cesareyeserrano/esp32-desk-controller/docs/historia/README.md

# Historia

Documentos de origen, **congelados**. No se editan ni se corrigen, ni siquiera
cuando contienen errores.

Están aquí para poder reconstruir qué se creía en cada momento. Un documento
histórico corregido a posteriori pierde exactamente lo que lo hace útil.

## Contenido

### `HANDOVER-2026-07-27.md`

Handover consolidado de las sesiones previas a la existencia de esta política.
Fuente de casi todo lo que hoy está repartido por los documentos temáticos.

**Contiene un error conocido:** el circuito de divisores que propone
(800 Ω / 1.72 kΩ) rompería el bus. Corregido en
[ADR-005](../DECISIONS.md). **No montar el cableado que describe.**
