cesareyeserrano/esp32-desk-controller/docs/SEGURIDAD.md

# Safety

> Reviewed before opening every new phase.
>
> *Documento en inglés desde el 2026-09-02. La bitácora y los ADR siguen en
> español; ver [POLITICA_DOCUMENTACION.md](POLITICA_DOCUMENTACION.md).*

---

## Electrical risk (phases 2 and 3)

**Unplug the desk from mains for any resistance or continuity measurement.**
Measuring resistance on a powered circuit gives false readings and can damage
the multimeter.

**Never force SDA high with a push-pull output.** While the AiP650 is pulling
that line down, doing so is a short circuit against the chip's own output. The
chip cannot be replaced, and the whole handset goes with it. See
[ADR-011](DECISIONS.md).

**The 6-wire cable between the two columns is never touched.** It carries the
**29 V** from the adapter and the motor current. There is nothing in there that
this project needs.

**The ESP32 is never powered from the desk, not even from its 5 V.** Those 5 V
are generated by the control box for a chip that draws 0.3 mA, while an ESP32
with WiFi spikes into the hundreds of milliamps, and nobody knows what that
regulator tolerates. USB from the Mac, always. See [ADR-007](DECISIONS.md).

**The yellow wire (5 V) never connects to the ESP32.** Not in any phase. The
ESP32 is USB powered ([ADR-007](DECISIONS.md)).

**No 5 V line ever touches a GPIO directly.** ESP32 GPIOs tolerate 3.6 V as an
absolute maximum. This covers the data lines ([ADR-005](DECISIONS.md)) and the
buttons ([ADR-004](DECISIONS.md)).

**Before connecting the ESP32, confirm the handset still works with the taps
soldered on.** Skip that order and any later fault becomes impossible to pin
down: was it the solder joint or the probe?

**Power the ESP32 over USB before connecting the wires to the divider, and
disconnect those wires before removing USB.** With the ESP32 unpowered and the
probe sitting on a live bus, the GPIO protection diode clamps the divider node
and drags the bus down to about 2.85 V, below the chip's threshold, so the
handset fails. There is no damage, since the current is around 210 µA limited by
the 9.1 kΩ, but the symptom would show up right after soldering and point at the
joints. See [ADR-019](DECISIONS.md).

**Check the bus level with the multimeter before accepting the assembly, and
judge by the ratio between two readings rather than an absolute threshold.** A
multimeter averages and the bus is switching, so both readings come out below
the calculated value by an unknown amount. Measure red to blue and green to blue
without the probe and then with it, desk still and the same number on screen:
the ratio should sit around **0.80**, and anything below **0.70** means
disconnect. Full procedure in [HARDWARE.md](HARDWARE.md), reasoning in
[ADR-018](DECISIONS.md).

---

## Mechanical risk (phase 3 onward)

A desk that moves on its own can trap hands, cables or pets. The surface lifts
with enough force to raise a monitor, which is enough force to hurt someone.

⚠️ **A real failure, twice: the desk ran into its bottom stop** (2026-09-25
11:41 and 2026-09-29 15:41, both descending from 115 to 73 cm). The give-way to
the handset drops the trip **without braking**, because it assumes the person's
own press already stopped the desk. But the press was the firmware's own: it
attributes only the FIRST reading of its own key, and it often misses that
reading, because it decodes just the last 2-3 ms burst of the pulse against a
~40 ms keyboard scan. When the give-way lands right as the long pulse starts
continuous travel, **nothing brakes it**: only the physical stop.

**Fixed the same day, [ADR-035](DECISIONS.md)**: a press is claimed by key code
for the whole window, and giving way during a trip now brakes, which `stopTravel`
verifies and retries. **Verified in the field on 2026-09-30**: a reminder descent
braked at the target by itself, 81 then 80. The cost is deliberate: a person
HOLDING a key has their travel braked once. Detail in
[BITACORA.md](BITACORA.md).

Rules for whenever actuation exists:

- **Software height limits**, minimum and maximum, checked against the height
  read from the bus. A command outside that range does not run.
- **No automatic movement without presence.** Automations that move the desk
  require confirmation that somebody is in front of it.
- **A stop is always available.** The physical handset stays connected and
  working through every phase. It is the panic button.
- **M1 and M2 pulses are bounded in hardware** ([ADR-010](DECISIONS.md)). A long
  close writes the preset instead of recalling it, and it fails silently.
- **A hung ESP32 is not hypothetical: it hung twice on 2026-08-03.** Not from a
  logic bug but from an electrical condition on a pin. A 175 kHz signal left it
  unresponsive, and it did not degrade gracefully.

  **Corrected on 2026-08-06, because this evidence was being cited with more
  force than it carries:** those hangs came from **interrupt saturation**, with
  `attachInterrupt` hooked to both pins. **That capture design no longer
  exists.** The sniffer moved to burst sampling and hooks no interrupts to those
  lines. The specific mechanism that was demonstrated is gone.

  What still stands is the generic part. Any firmware can hang some other way,
  and the current one disables interrupts for 2 ms per burst. But **this is a
  reasonable precaution, not a requirement backed by direct evidence.** The
  difference matters when the decision involves buying components.

  What does not change: **the only thing that can open a closed channel with
  dead firmware is hardware that does not depend on the CPU.**
- ⚠️ **Button wires go to pins 3 and 4 of the PC817, never to 1 and 2.** Pins 1
  and 2 are the LED and already carry the ESP32; pins 3 and 4 are the isolated
  switch. Soldering the button to pins 1 and 2 would tie the handset's 5 V to the
  ESP32 GPIO and destroy the isolation entirely.

- **All four channels carry the same 300 ms pulse limiter**
  ([ADR-023](DECISIONS.md)). Decided on 2026-08-06, closing what was blocking
  phase 3. **The firmware only emits taps; the hardware guarantees none lasts
  longer.**

  **Corrected on 2026-08-23, and it is an uncomfortable correction:** from the
  day this was written until then, **that watchdog did not exist**.
  [ADR-024](DECISIONS.md) decided it and nobody implemented it. The firmware
  configured no watchdog at all, and the pulse width was bounded by the very
  software that might hang. This document's promise was paper. The adversarial
  review of 2026-08-23 found it
  ([REVISION_FIRMWARE_2026-08-23.md](REVISION_FIRMWARE_2026-08-23.md), finding
  B1).

  **Since 2026-08-23 it does exist:** every pulse arms the ESP32 task watchdog
  with a budget of `width + 1 s` and panics on expiry. A hang with the pin high
  ends in a chip reset, the reset leaves the GPIOs as inputs, and the channel
  opens. It disarms when the pin is released. Verified in normal operation: it
  does not fire on legitimate pulses.

  **And the pulse now measures itself:** on release it compares the width
  achieved against the width requested, and any overrun beyond 100 ms is
  reported with `[!!]`. Bus decoding used to happen **inside** the contact and
  could stretch it without anyone knowing (finding B2). Now the capture happens
  during the pulse and the decoding after release.

  ⚠️ **Before wiring anything, measure the level of the control GPIOs during
  boot and reset.** All of this protection rests on a reset leaving the pins non
  conducting. **If any of them goes high at boot, the watchdog would activate
  the channel instead of opening it.**

  The measured thresholds behind this: a tap becomes **continuous travel**
  between **2.2 and 2.6 s**, and M1 or M2 **overwrite the preset** at **3.0 s**.
  At 300 ms there is seven times the margin below, and almost double the 160 ms
  minimum the chip needs to see a press at all.

  So **a stuck contact cannot start continuous travel or overwrite a preset**.
  At worst it moves a centimetre or recalls a memory.

- ⚠️ **Continuous travel cannot be stopped by opening a contact.** Measured:
  after release the desk kept going **5 cm in 5 s** upward and **6 cm in 6.6 s**
  downward. Stopping it requires **closing** a contact, not opening one, which
  is why no circuit acting on absence of signal is any use here.

  **Changed on 2026-08-21 ([ADR-028](DECISIONS.md)).** The design used to be
  *prevent continuous travel from ever starting*. It is now **admitted**, because
  the missing measurement was taken: **a short tap on the SAME channel brakes its
  own continuous travel**. With a single channel wired, there is a stop.

  ⚠️ **New risk, and of a different kind:** an ESP32 hang during travel leaves
  the desk moving with **nothing to stop it**. The watchdog from
  [ADR-024](DECISIONS.md) **does not help**, because it opens the channel, and
  opening does not brake. What remains is the physical stop and the handset.
  **That is a mitigation, not a guarantee.**

  **Hence: continuous travel only under supervision**, for as long as software
  limits based on the bus height do not exist. Taps
  ([ADR-027](DECISIONS.md), 800 ms) carry no such risk and remain the default
  mode.
- **A brake is always available.** Any button stops movement in progress, so any
  relay works as an emergency stop. Faced with an incoherent height reading,
  braking is the default action, not carrying on.
- **No movement starts on a stale height** ([ADR-012](DECISIONS.md)). If the
  display refresh stops or jumps incoherently during a movement, it brakes.
- **No retry loops.** If a movement does not reach the expected height, it stops
  and reports. It does not retry on its own: a misdecoded sensor retrying
  forever is a desk hammering against an end stop.
- **The reset button is never wired** ([ADR-008](DECISIONS.md)). It runs a
  recalibration that drives the surface down to the bottom stop, with no
  confirmation and no way to interrupt it. It stays physically out of the
  circuit, because that is stronger than a software check some bug can skip.

---

## The pulse cannot be aborted: a 2800 ms window

**Found on 2026-09-02**, from a question by the owner: *"my worry is when an HA
automation fires and I stop the desk by hand"*.

**Electrical risk: none, and this part is reasoned.** The optocoupler sits **in
parallel** with the handset button. Closing both at once is electrically
identical to pressing one key with two fingers: two switches in parallel, no
current conflict, and no way to damage anything.

**The risk is logical, and it is unevaluated.** During the pulse the channel
stays closed for **2800 ms with no way to abort**, because bus decoding happens
*after* the contact opens. That ordering comes from correction B2 of 2026-08-23,
which exists because decoding inside the pulse stretched it dangerously close to
the 3.0 s that overwrite a preset. While the pulse lasts, **the firmware is
blind to a person having pressed anything**.

If **the opposite key** is pressed inside that window, the control box sees
**UP and DOWN closed at the same time**.

⚠️ **What the box does with that combination IS NOT VERIFIED.** On desks of this
kind it is usually the way into calibration mode, which would lose the height
reference. Recoverable, but not tested here. **Assumed, not measured.**

**And it is not theoretical.** On 2026-09-02, with the reminder moving the desk:

```
09:31:54.0  the ESP32 closes UP (until ~09:31:56.8)
09:31:55    the owner presses UP     <- inside the window, same key: harmless
09:31:57    presses DOWN             <- ~200 ms after the contact opened
```

**The opposite key, two tenths of a second outside the window.**

**Mitigations, none applied:**

1. **Decode inside the pulse without printing**, so the contact can open as soon
   as an unattributed key shows up. This collides head on with correction B2, so
   it would need careful bounding to stay away from 3.0 s.
2. **Use the M1 and M2 presets** for the posture targets. The pulse drops from
   2800 to 800 ms and the box handles the travel. Needs an ADR, since it
   contradicts the owner's decision not to couple the physical presets to the
   system.

**Pending and cheap check:** press UP and DOWN together on the handset **with
the ESP32 disconnected**, and see what happens. That is the only thing that
turns this assumption into a fact. Proposed on 2026-09-02; the owner closed the
session before deciding.

## Risk of losing the desk

The control box is proprietary and does not get opened. If its configuration is
corrupted or the handset is damaged, there is no immediate replacement and no
way to diagnose it.

That is the reason for the read-only phase ([ADR-002](DECISIONS.md)): as long as
nothing is written to the bus, no ESP32 bug can alter the desk's state.
