cesareyeserrano/esp32-desk-controller/docs/historia/README-2026-07-27.md

# Escritorio elevable automatizado — ESP32 + Home Assistant

Automatizar un escritorio elevable Jiecang leyendo el bus de datos entre su caja
de control y el mando físico, para conocer la altura real en todo momento y
mover el escritorio a posiciones definidas desde Home Assistant.

## Estado

**Fase 2 — Sniffing del bus. Montaje pendiente.**

El hardware está identificado y el **pinout del cable verificado** por
continuidad: **rojo = CLK, verde = DIO, azul = GND, amarillo = 5 V**. Esto
corrige el handover original, que daba el rojo como alimentación.

El circuito de sonda está **definido**: divisor de 9.1 kΩ / 27 kΩ en rojo y
verde ([ADR-016](../DECISIONS.md)). Las 9.1 kΩ ya están; faltan **dos
resistencias de 27 kΩ** y nada más.

El firmware del sniffer está escrito, en
[firmware/desk_sniffer/](firmware/desk_sniffer/), aunque **sin compilar ni
probar**.

## Estado: el protocolo está descifrado ✅

**El 2026-08-06 se leyó la altura del escritorio directamente del bus**, y se
verificó contra lo que muestra la pantalla del mando en cuatro casos, incluido
uno de tres dígitos:

| Acción | Pantalla | Bus |
|---|---|---|
| Subir manual | 86 | `086` |
| Bajar manual | 77 | `077` |
| Ir a memoria | 117 | `117` |
| Ir a memoria | 80 | `080` |

**Y la altura se refresca durante el movimiento**, cada centímetro. Ese era el
riesgo que podía tumbar el proyecto entero: si el escritorio solo publicara la
altura al terminar de moverse, el lazo cerrado no funcionaría. **Funciona.**

Los cuatro botones están mapeados —subir `0x47`, bajar `0x57`, memorias `0x6F` y
`0x67`— y el reset queda sin capturar a propósito
([ADR-008](../DECISIONS.md)). Todo en [PROTOCOLO.md](../PROTOCOLO.md), con
las capturas crudas en [docs/capturas/](docs/capturas/).

Para llegar aquí hubo que reescribir la captura del sniffer: el bus corre a
**~202 kHz** y la captura por interrupción perdía flancos en silencio. Ahora
graba a ráfagas de 4 MHz y decodifica después.

**La fase 3 se cerró el 2026-08-22: el ESP32 controla el escritorio entero.**
Los cuatro canales verificados contra el bus, y los cuatro códigos coinciden con
los que se habían decodificado en julio leyendo el tráfico:

| Canal | Pin | Botón | Código |
|---|---|---|---|
| 1 | GPIO 27 | Subir | `0x47` |
| 2 | GPIO 26 | Bajar | `0x57` |
| 3 | GPIO 25 | Memoria 80 cm | `0x67` |
| 4 | GPIO 33 | Memoria 117 cm | `0x6F` |

El lazo está cerrado **dentro del firmware**: se pide una altura por MQTT o
desde Home Assistant y el ESP32 viaja, supervisa y frena solo — con límites,
freno verificado y detección de dirección invertida. El reset
sigue deliberadamente sin cablear ([ADR-008](../DECISIONS.md)).

Siguiente acción concreta: **fase 4 — integrar con Home Assistant**. El catálogo
de lo que se va a exponer está en
[INTEGRACION_HA.md](../INTEGRACION_HA.md); el orden de trabajo, en
[PLAN.md](../PLAN.md).

**Empieza por los límites de altura por software**, que es lo que permitirá
quitar la supervisión del movimiento continuo ([ADR-028](../DECISIONS.md)).

⚠️ **Antes de tocar el accionamiento, dos reglas que costaron una tarde:** mandar
`h` y comprobar que el sketch responde ([ADR-026](../DECISIONS.md)), y **si el
escritorio se mueve pero la captura dice que no ha pasado nada, el sospechoso es
la captura**.

⚠️ **El movimiento continuo (`A B C D`) solo con supervisión** hasta que existan
los límites por software: un cuelgue durante el viaje deja el escritorio en
marcha y el watchdog no lo para ([ADR-028](../DECISIONS.md)).

## Mapa de la documentación

| Archivo | Qué contiene | Cuándo se toca |
|---|---|---|
| [INTEGRACION_HA.md](../INTEGRACION_HA.md) | Qué expone el escritorio a Home Assistant y por qué | Al diseñar o cambiar la integración |
| [docs/PLAN.md](../PLAN.md) | Fases, alcance y qué falta | Al cerrar o abrir una fase |
| [docs/DECISIONS.md](../DECISIONS.md) | ADRs: decisiones y su porqué | Al decidir algo que cuesta revertir |
| [docs/BITACORA.md](../BITACORA.md) | Diario de sesiones y mediciones | En **cada** sesión con hardware |
| [docs/HARDWARE.md](../HARDWARE.md) | Inventario, pinouts, medidas, planos | Al medir o cambiar el montaje |
| [docs/PROTOCOLO.md](../PROTOCOLO.md) | Lo descifrado del bus del mando | Al avanzar en la decodificación |
| [docs/SEGURIDAD.md](../SEGURIDAD.md) | Riesgos eléctricos y de movimiento | Antes de cada fase nueva |
| [docs/REFERENCIAS.md](../REFERENCIAS.md) | Fuentes externas y qué se sacó de cada una | Al consultar algo fuera |
| [docs/COMPRAS.md](../COMPRAS.md) | Qué falta comprar y por qué | Al detectar que falta algo |
| [docs/capturas/](docs/capturas/) | Volcados crudos del sniffer | Cada captura, sin editar |
| [docs/hardware/](docs/hardware/) | Datasheets, planos y fotografías del hardware | Al depender de una fuente externa |
| [docs/historia/](docs/historia/) | Documentos de origen, congelados | Nunca se editan |
| [firmware/](firmware/) | Código del ESP32 | |

La política que gobierna todo esto está en
[docs/POLITICA_DOCUMENTACION.md](../POLITICA_DOCUMENTACION.md). **Léela antes
de escribir en cualquier otro archivo.**

## Hardware

ESP32 DevKit de 38 pines sobre placa de expansión con borneras, módulo de 4
relés, multímetro. Mando `JK-CH506 Rev1.2` con chip AiP650EO (familia TM1650).
Detalle completo en [docs/HARDWARE.md](../HARDWARE.md).

## Destino

Home Assistant sobre Ultron (Raspberry Pi 5). Más adelante, frontend propio
contra la API WebSocket de HA.
