cesareyeserrano/esp32-desk-controller/docs/historia/HANDOVER-2026-07-27.md

# Proyecto: automatizar escritorio elevable con ESP32 + Home Assistant

Handover para continuar en Claude Code. Contiene todo lo verificado hasta hoy,
las decisiones tomadas y por qué, y el siguiente paso concreto.

---

## Objetivo

Que un ESP32 pueda:

1. Mover el escritorio a posiciones definidas.
2. Saber en qué altura está el escritorio en todo momento, incluso si alguien
   lo mueve con el mando físico.

Integración final en Home Assistant (corre en "Ultron", Raspberry Pi 5).
Más adelante, posiblemente una app web propia encima de la API de HA.

---

## Hardware disponible

- **ESP32 DevKit 38 pines** montado sobre placa de expansión con borneras de
  tornillo. Serigrafía de la placa: `HW-395 V0.0.3` / `DT-Y6593`.
- **Módulo de 4 relés** Songle SRD-05VDC-SL-C, con optoacopladores y jumper JD-VCC.
- Resistencias surtidas de 1/4 W (bolsa de valores mixtos).
- Multímetro. Cautín y estaño. Sin osciloscopio ni analizador lógico.
- MacBook Air M4 para programar por USB.

---

## El escritorio

- Mando/handset: PCB marcada **`JK-CH506 Rev1.2`** / `G9008B-3E-4137-202518`.
  "JK" apunta a Jiecang, fabricante chino de actuadores para escritorios.
- El mando tiene **5 pulsadores táctiles** y un display de 7 segmentos con
  matriz de LEDs.
- Chip único del mando: **AiP650EO** (marcado `19BT450`, SOP-16).
  Es driver de display de 7 segmentos + escáner de teclado, **con interfaz I2C**.
- **No hay microcontrolador en el mando.** El cerebro está dentro de la base
  del motor, que no se ha abierto y no hace falta abrir.
- El mando se conecta a la caja de control por un **cable de 4 hilos** con
  conector JST blanco de 4 pines (paso pequeño, tipo PH/ZH).

### Pinout del cable, verificado con multímetro

| Color | Función | Cómo se determinó |
|---|---|---|
| **Azul** | GND | Único punto contra el cual los otros tres dan ~5 V. Entre cualquier par que no incluya azul, la lectura es ~0 V. |
| **Rojo** | VCC (5 V) probable | En reposo ~5 V. No confirmado cuál de los tres es VCC exactamente. |
| **Amarillo** | Datos (SDA o SCL) | ~5 V en reposo. |
| **Verde** | Datos (SDA o SCL) | ~5 V en reposo. |

Notas:

- Las tres líneas no-azul miden ~4.x V porque en I2C las líneas en reposo
  están en alto por los pull-ups.
- **No se ha determinado cuál es SDA y cuál es SCL.** Se resuelve escuchando:
  SCL es la que tiene un tren de pulsos regular, SDA la que cambia entre ellos.
- Continuidad al chasis metálico del motor: **ninguno de los 4 cables da
  continuidad**. Es normal, la fuente es flotante y/o el chasis está pintado.
  No invalida la identificación del azul como GND.

### Los pulsadores

- Los pulsadores táctiles de 4 patas: las patas del mismo lado están unidas
  internamente, las **diagonales** son el par que el botón cierra al presionar.
- **Medido: entre las patas de un pulsador hay 5 V.**
- Consecuencia crítica: **no se pueden conectar directo a un GPIO del ESP32**,
  que solo tolera 3.6 V. Si se quisiera accionar por ahí, habría que usar los
  relés como contacto seco.

---

## Decisiones tomadas y por qué

### 1. La ruta principal es el bus I2C, no los pulsadores

Razón: sin leer la altura real, automatizar es contar segundos, y eso deriva
(la velocidad varía con el peso, el motor arranca con rampa, y si alguien mueve
el escritorio a mano el ESP32 no se entera). Con el bus se cierra el lazo.

Como el AiP650 recibe por I2C **los dígitos que muestra el display**, escuchando
el bus se obtiene la altura literal, la misma que se lee en pantalla. Y como el
mismo chip escanea el teclado, las pulsaciones también viajan por ahí.

### 2. Se escucha primero, no se inyecta

Fase actual: **solo lectura, en paralelo**. El mando queda conectado y funcional.
No se corta nada. Inyectar comandos vendrá después, si el protocolo se descifra.

### 3. Los relés siguen en el plan como plan B de accionamiento

Si leer funciona pero inyectar no, el híbrido es: leer altura por el bus,
accionar por relés en paralelo a los pulsadores (contacto seco, aísla y no le
importan los 5 V). 4 relés bastan: subir, bajar, y dos memorias. El 5º botón
probablemente es "M" (grabar preset) y no conviene automatizarlo.

Idea clave si se va por relés: **usar las memorias del escritorio** en vez de
temporizar. La caja de control ya sabe llegar a la altura exacta sola.

### 4. Divisores resistivos obligatorios

Las líneas son de 5 V. Cada una necesita un divisor antes del GPIO.

---

## Estado actual del montaje

**Pendiente de armar.** El plano está definido, las resistencias identificadas,
falta la conexión física.

### Resistencias medidas disponibles

| Colores | Valor medido |
|---|---|
| Amarillo–Violeta–Dorado–Dorado | 4.7 Ω |
| Gris–Rojo–Café–Dorado | 800 Ω (hay dos) |
| Verde–Azul–Café–Dorado | 560 Ω |
| Café–Gris–Rojo–Dorado | 1.72 kΩ (hay dos) |
| Rojo–Naranja–Rojo–Dorado | ~2.3 kΩ (anotado como 3.2 k, **verificar**) |
| Gris–Rojo–Rojo–Dorado | 8.2 kΩ |
| Violeta–Verde–Naranja–Dorado | 75 kΩ |
| Rojo–Amarillo–Amarillo–Dorado | 240 kΩ |
| Rojo–Rojo–Verde–Dorado | 2.2 MΩ |

También hay **dos de 920 Ω**, que sirven igual de bien que las de 800.

### Divisor elegido

Por línea: **800 Ω (o 920 Ω) arriba, 1.72 kΩ abajo.**

- Con 800/1720 → 3.42 V
- Con 920/1720 → 3.26 V

Ambos dentro de rango. Hay dos pares completos, así que se montan las dos
líneas de datos a la vez.

### Cableado

```
AMARILLO ──[800 Ω]──┬──> P16 del ESP32
                    └──[1.72 kΩ]──> GND

VERDE ─────[800 Ω]──┬──> P4 del ESP32
                    └──[1.72 kΩ]──> GND

AZUL ───────────────────> GND del ESP32

ROJO ───────────────────  no se conecta
```

- El GPIO va **al nodo entre las dos resistencias**, nunca al extremo.
- Todos los GND van juntos: las patas inferiores de las dos resistencias de
  1.72 k, el cable azul, y el GND del ESP32.
- **P16, P4 y GND están todos en la bornera derecha** de la placa de expansión
  (con el USB-C hacia abajo, según la foto de referencia). P16 y P4 son
  adyacentes; P17 queda justo encima de P16. El GND más cómodo es el de la
  esquina superior de esa misma columna.
- Se evitaron a propósito los GPIO de arranque: 0, 2, 12, 15.
- **ESP32 alimentado por USB desde el Mac.** No tomar los 5 V del escritorio
  durante la fase de sniffing.

### Dónde pinchar

En la placa del mando, los 4 pines del conector JST están soldados y accesibles
por el reverso. Se sueldan cablecitos finos (AWG 28) a cada pin, dejando el
conector original puesto.

---

## Siguiente paso: sniffer I2C

**Esto es lo primero que hay que construir en Claude Code.**

El sketch previo (`desk_sniffer.ino`, generado en la sesión anterior) asumía
UART y **ya no aplica**. Hay que rehacerlo para I2C.

Requisitos del sniffer:

1. Determinar cuál de las dos líneas es SCL y cuál SDA. SCL tiene tren de
   pulsos regular; SDA cambia entre pulsos de reloj.
2. Capturar transacciones I2C en modo pasivo (el ESP32 no es master ni slave,
   solo observa). Decodificar START, dirección + R/W, bytes de datos, ACK/NACK,
   STOP.
3. Volcar por serial en hex con marcas de tiempo, agrupado por transacción.
4. La dirección I2C esperada del AiP650 y su mapa de registros hay que
   consultarlos en el datasheet; el chip usa comandos de display digit-by-digit
   y un registro de lectura de teclado.

Consideraciones técnicas:

- El I2C del AiP650 suele correr lento (decenas a cientos de kHz). Un ESP32 a
  240 MHz puede muestrear por bit-banging con interrupciones, pero hay riesgo
  de perder bordes. Alternativa robusta: usar el periférico RMT o I2S del ESP32
  para captura, o el driver I2C en modo slave-snoop si el framework lo permite.
- Empezar por lo simple: interrupciones en flanco de SCL, leer SDA en cada
  flanco de subida, detectar START/STOP por transiciones de SDA con SCL alto.

### Plan de captura

1. Encender el escritorio con el ESP32 desconectado. Verificar que el mando
   funciona normal. Si algo cambió, las derivaciones rompieron algo.
2. Conectar el ESP32 por USB, correr el sniffer.
3. Con el escritorio quieto: debería verse tráfico continuo, que es la caja
   refrescando el display. Ahí está la altura.
4. Presionar un botón a la vez y anotar qué transacción aparece.
5. Mover el escritorio y correlacionar los bytes del display con el número que
   se ve en pantalla. Eso da la decodificación de altura.

---

## Fases posteriores

**Fase 3 — Accionar.** Según lo que revele la captura:

- Si se identifican los comandos de botón y se puede inyectar en el bus →
  control completo por los 4 cables. Ojo con la colisión: el mando y el ESP32
  compartirían el bus. I2C es open-drain por diseño, lo que ayuda, pero hay que
  manejar arbitraje o desconectar el mando lógicamente.
- Si no → híbrido: leer por el bus, accionar por relés sobre los pulsadores.

**Fase 4 — ESPHome / Home Assistant.** Exponer la altura como sensor y los
presets como botones o `cover`. Custom component si el protocolo lo requiere.

**Fase 5 — App.** Frontend propio contra la API WebSocket de HA. Estética HUD
tipo JARVIS (cyan, JetBrains Mono), consistente con Aitri Hub. Métricas
interesantes: horas sentado vs de pie, recordatorio de cambio de postura,
subir automáticamente al arrancar la primera reunión de la tarde.

---

## Seguridad

Un escritorio que se mueve solo puede atrapar manos, cables o mascotas. Al
llegar a la automatización: definir límites de altura por software y evitar
movimientos disparados sin que haya alguien presente.

---

## Notas sobre cómo se llevó la conversación anterior

La sesión previa cambió de recomendación varias veces (relés → cable → relés →
cable), lo que generó confusión. Para esta continuación conviene:

- Sostener el plan definido arriba y no reabrir la decisión sin evidencia nueva.
- Ir por pasos pequeños, uno a la vez, verificando antes de avanzar.
- Preferir respuestas cortas y concretas sobre explicaciones largas.
