cesareyeserrano/esp32-desk-controller/docs/plantillas/entrada-bitacora.md

## AAAA-MM-DD — título corto de qué se intentó

**Objetivo de la sesión:** una frase. Qué se quería saber o lograr.

**Estado del montaje al empezar:** qué estaba conectado y qué no.

### Qué se esperaba

Escribir esto **antes** de medir. Si no hay expectativa, no hay experimento.

### Qué se hizo

Pasos en orden. Instrumento, escala, puntos de medida y contra qué referencia.

### Resultados

| Medida | Valor | Cómo se midió |
|---|---|---|
| | | |

Números con unidades. Si algo salió distinto de lo esperado, decirlo aquí sin
interpretarlo todavía.

### Interpretación

Qué significan los números. Marcar cada afirmación como **verificado**,
**supuesto** o **descartado**.

### Estado del montaje al terminar

Qué quedó conectado, soldado, suelto o a medias. Cualquiera debe poder retomar
sin abrir nada para averiguarlo.

### Siguiente paso

Una acción concreta. No un área.

### Archivos generados

Capturas en `capturas/`, actualizaciones a otros documentos, ADRs escritos.
