cesareyeserrano/esp32-desk-controller/(commit log)

2026-08-23 Escritorio Jiecang automatizado con ESP32 y Home Assistant
    Ingeniería inversa del bus entre la caja de control y el mando físico, sin
    abrir la caja, sin modificar el mando y sin perder su uso manual.
    Qué funciona:
    - Lectura de altura decodificando el bus del AiP650E a ~202 kHz
    - Accionamiento por cuatro optoacopladores en paralelo con los pulsadores
    - Viajes a una altura concreta, supervisados y con freno verificado
    - 19 entidades en Home Assistant por MQTT discovery
    La documentación es parte del proyecto, no un añadido: 33 ADR con su porqué,
    capturas crudas con contexto obligatorio, y una bitácora que incluye los
    caminos equivocados — cada afirmación marcada como verificada, sup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
2026-08-24 Segunda ronda adversarial: corrige regresiones del estado BRAKING
    Ocho ángulos nuevos sobre el sistema completo. Tres encontraron por separado
    que los arreglos de la ronda anterior introdujeron regresiones:
    - El reobjetivo (`ir:N` durante un viaje) se descartaba en silencio, porque el
    freno deja el estado en BRAKING y el viaje nuevo se rechazaba. Ahora el
    objetivo espera a que el freno confirme y se ejecuta solo. Verificado en vivo
    - El ajuste fino se cancelaba si el frenado tardaba más de 2.5 s; ahora espera
    - Reentrar en `parar` durante el frenado reseteaba la escalada del freno fallido
    - Un `parar` podía dejar un movimiento encolado que se ejecutaba después
    - HA veía "quieto" du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
    [desk_sniffer.ino]
2026-08-24 Actualizaciones de firmware por red (OTA)
    El ESP32 vive en un cargador de pared, así que cada corrección obligaba a mover
    el USB entre el cargador y el Mac. Ese tránsito reproduce la condición del
    ADR-019 —placa sin alimentar con la sonda sobre un bus vivo— que ya costó dos
    días de diagnósticos falsos: el procedimiento de arreglo era más arriesgado que
    casi cualquier fallo del firmware.
    - ArduinoOTA con contraseña, en secrets.h (no versionada)
    - La IP se publica como entidad: sin ella no se sabe a dónde actualizar
    - La actualización se RECHAZA si el escritorio está en movimiento: reiniciar
    abre los canales, y abrir un contacto no detiene el movimiento continuo
    Verificado: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
    [desk_sniffer.ino]
2026-08-24 El ESP32 cede el paso al mando físico, y seis arreglos de su revisión
    El sniffer ve todas las teclas del bus, propias y humanas. Si durante un viaje
    aparece una tecla que el ESP32 no ordenó, cede: suelta su objetivo, no frena
    (la pulsación humana ya frenó) y no persigue. Antes tardaba 9 s en concluir
    "no avanza" y metía un toque que nadie pidió. Sensor nuevo `uso_manual` para
    que las automatizaciones no se peleen con la persona.
    La revisión adversarial de esta implementación —regla del proyecto desde hoy—
    encontró seis fallos, dos graves:
    - El "rechazo" del OTA en movimiento reiniciaba el chip, que es exactamente la
    fuga que decía evitar (reiniciar abre los canales y abrir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
    [desk_sniffer.ino]
2026-08-24 Cierre de sesión: documentación al día y siguiente paso
    - ADR-034 corregido con nota fechada: el rechazo OTA original (ESP.restart)
    ejecutaba la fuga que decía evitar; ahora frena primero
    - INTEGRACION_HA: uso_manual y la cesión al mando marcados como implementados
    y verificados; sección del panel
    - PLAN: el sistema queda estable en observación; próximos pasos por orden de
    valor (presets con nombre, capas de protección de la sonda, estadísticas)
2026-08-24 LED con latido, y la valoración honesta del proyecto al cerrar
    El LED de la placa queda apagado por defecto, con interruptor en HA. Encendido
    parpadea 40 ms cada 5 s en vez de quedarse fijo: dice "vivo" de un vistazo sin
    iluminar la habitación.
    Y queda escrita en la bitácora la pregunta del propietario al cerrar —si valía
    la pena, teniendo el botón a 30 cm— con la respuesta honesta: para subir y
    bajar el escritorio, no hacía falta; una alarma en HA habría cubierto el
    recordatorio de postura sin riesgo. El valor real estuvo en descifrar un
    protocolo propietario sin osciloscopio, y en documentar los errores con su
    fecha y su porqué.
    Si se repitiera: el buffer de protección de la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
    [desk_sniffer.ino]
2026-08-24 El LED de esta placa no se puede apagar: entidad retirada
    La única luz del DevKit es un LED rojo de alimentación cableado a la línea de
    3.3 V; ningún GPIO llega hasta él. El firmware aceptaba el comando y publicaba
    ON mientras la luz seguía igual.
    Se retira la entidad de HA —un interruptor que visiblemente no hace nada es
    peor que no tenerlo— y se limpian sus retenidos del broker. El latido en GPIO2
    se conserva tras la tecla 'L' por serie: cualquier placa con el LED azul
    habitual sí lo tendría.
    Para apagarlo: cinta aislante.
    [desk_sniffer.ino]
2026-08-24 Recordatorios de postura con sensor de presencia
    Lo primero del proyecto que aporta algo que una alarma no da: avisa solo si
    estás delante. 45 min sentado -> ofrece subir a 117; 30 min de pie -> ofrece
    bajar a 80. No mueve el escritorio por su cuenta: lo ofrece en la notificación
    y espera la pulsación, como exige SEGURIDAD.md.
    Hizo falta un sensor derivado: `altura` publica unknown cuando el display
    duerme, así que no sirve para medir tiempo en una postura. Dos sensores
    plantilla conservan la última lectura real y derivan la postura (umbral 95 cm).
    Trampa documentada: el disparador del template con sintaxis nueva dentro de la
    clave antigua pasa la validación de HA y no dispara nunca,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
2026-08-24 Los recordatorios mueven el escritorio, y sin toques periódicos
    Dos correcciones a partir de dos preguntas del propietario:
    "si solo avisa para moverse, ¿qué sentido tiene el ESP?" — ninguno, eso lo hace
    una alarma. La versión anterior solo notificaba con un botón: precaución de más
    que vaciaba el sistema de su utilidad. SEGURIDAD.md pide "confirmación de que
    hay alguien delante", y el sensor de presencia ES esa confirmación. Ahora
    mueven, avisan y ofrecen deshacer.
    "¿va a enviar un toque cada rato?" — sí, y era mala idea. El resumen despertaba
    el display cada 30 min: desgaste del pulsador y luz encendida para leer un
    número que casi nunca cambia. Retirado.
    Añadida la cor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
2026-08-24 Re-verificar presencia antes de mover: el sensor tarda 90 s en soltar
    Detectado por el propietario: el SNZB-06P tiene 90 s de retardo
    ocupado->desocupado, así que en esa ventana informa "presente" con la silla ya
    vacía y la automatización habría movido el escritorio sin nadie delante — lo
    que SEGURIDAD.md prohíbe.
    Bajar el retardo del sensor no servía: acortarlo hace que cada ausencia breve
    reinicie el contador de postura y los avisos no lleguen nunca.
    La secuencia pasa a ser: avisar -> esperar 110 s (más que el retardo) ->
    comprobar presencia OTRA VEZ -> mover. Si te levantaste, para entonces el
    sensor ya lo sabe y no pasa nada.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
2026-08-24 Tres capas contra la ausencia: el sensor no sabe al instante que te fuiste
    "da igual, me puedo ir justo en la confirmacion" — cierto: una comprobación
    puntual reduce la ventana, no la cierra.
    1. Retardo del sensor de 90 s a 30 s
    2. Re-verificar presencia tras 110 s, antes de mover
    3. Parar el escritorio si la presencia cae MIENTRAS se mueve
    La tercera es la que cierra el caso: no predice, reacciona.
    Y un error propio registrado: dije que bajar el retardo rompería el contador de
    postura. Es falso — ese contador mide la altura, no la presencia. Por ese
    razonamiento equivocado estuve a punto de descartar la mejora más simple.
2026-08-24 Los recordatorios de postura no disparaban: dos fallos silenciosos
    Detectado por el propietario: activas pero last_triggered NUNCA.
    1. El disparador esperaba una transición que no ocurre. "Cuando la postura
    CAMBIE a sentado y siga 45 min" no salta si el escritorio ya estaba a 80
    desde ayer: la postura ya era sentado. Ahora revisa cada 5 min cuánto lleva
    en la postura.
    2. Una condición contra un sensor inexistente. La cortesía usaba uso_manual,
    que el firmware solo publica DESPUÉS de que alguien toque el mando por
    primera vez. Sin tocarlo, el sensor no existe, la condición no se evalúa y
    bloqueaba la automatización entera. Ahora se interpreta como lo que
    signifi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
2026-08-24 Recordatorios de postura verificados de punta a punta
    45 min sentado -> aviso -> 2 min de margen -> re-verificación de presencia ->
    el escritorio sube solo a 117 -> aviso con botón para deshacer.
    Es el primer momento en que el sistema hace algo útil por su cuenta: mide la
    postura leyendo el bus, comprueba que hay alguien delante, espera por si te
    vas, mueve y ofrece deshacer.
    Nota: cuando parecía que "no hacía nada", a la automatización le faltaba un
    minuto. El contador de postura se reinicia con cada reinicio de HA, y en una
    sesión con muchos reinicios eso da la impresión de que está muerta.
2026-08-24 Especificación y esquema de la placa definitiva
    Sustituye la protoboard, que fue el eslabón frágil del proyecto: un corto entre
    hilos del bus y un optoacoplador flojo costaron dos días y estuvieron a punto
    de dar el mando por muerto.
    Cambio principal: buffer 74HC14 alimentado desde los 5 V del propio mando,
    entre el bus y el ESP32. Si el ESP32 pierde alimentación, su diodo interno ya
    no puede tirar del bus — el fallo que causó los dos días de diagnóstico falso.
    Dos inversores por línea, porque el 74HC14 invierte.
    Usa el hilo amarillo, que ADR-007 prohibía: esa prohibición era por alimentar
    el ESP32 (picos de cientos de mA). El 74HC14 consume microamperios. Queda
    acotada al buf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
2026-08-24 La placa se intercala en el cable, en vez de derivar del mando
    Propuesta del propietario, y mejora la seguridad más de lo que parece: elimina
    las TRES soldaduras del bus dentro del mando — justo las que produjeron el
    cortocircuito verde-amarillo y dos días de diagnóstico. Dentro solo quedan los
    ocho de los pulsadores, que no hay forma de evitar.
    [caja] --4 hilos--> [placa] --4 hilos--> [mando], y el mando devuelve los 8 de
    los pulsadores.
    Contrapartida registrada: la placa pasa a estar EN SERIE. Como derivación, si
    fallaba el mando seguía; intercalada, una pista rota deja el escritorio sin
    mando. Mitigado con pistas de paso directas y anchas, y un cable puente para
    saltarse la placa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
2026-08-24 Planos en tres láminas: el esquema anterior era ilegible
    "eso no se entiende" — cierto. El primer intento metía el sistema, el bus con
    su buffer y los cuatro canales en una sola imagen, y salió un amasijo. Un
    esquema que hay que descifrar no sirve para mandarlo a fabricar.
    Ahora son tres láminas, cada una con una sola cosa y espacio:
    1. Sistema: cómo se intercala la placa entre la caja y el mando
    2. Bus: los 4 hilos de paso y la derivación al buffer
    3. Canales: los cuatro optoacopladores, con uno ampliado como referencia
2026-08-24 El contador de postura mide a la persona, no la altura del escritorio
    Caso planteado por el propietario: si me voy al baño y vuelvo, ¿cuenta de cero?
    ¿y si vuelvo en una hora?
    El diseño lo hacía mal: el contador era "cuánto lleva el escritorio a esta
    altura", así que irse una hora no cambiaba nada — al volver afirmaba "llevas
    hora y media sentado" y subía la mesa justo cuando acababas de sentarte. Medía
    el mueble, no a la persona.
    Ahora un input_datetime marca el inicio del periodo de postura:
    - cambio de postura -> periodo nuevo
    - ausencia < 15 min (baño) -> no lo toca
    - ausencia >= 15 min -> reinicia y avisa cuánto estuviste fuera
    Los 15 min son un número elegido, no medid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
2026-08-25 El sensor de movimiento no se actualizaba, y con él moría una protección
    Detectado por el propietario usando el sistema.
    Regresión de la segunda ronda: para que la radio no se pusiera delante de una
    decisión de freno, dejé de publicar por MQTT durante el movimiento. Pero el
    estado de movimiento se publicaba dentro de esa función, así que HA solo veía
    "quieto", nunca "subiendo" ni "bajando".
    Lo grave no era el sensor: la automatización que para el escritorio si
    desaparece la presencia mientras se mueve consulta ese mismo sensor. No podía
    dispararse desde que se creó.
    Ahora el estado se publica en cuanto cambia. Verificado en un viaje real:
    quieto -> subiendo -> frenando -> quie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
2026-08-25 El sensor de movimiento detecta también el mando físico
    "si le pulso el mando no lee eso" — cierto: g_motion solo reflejaba los viajes
    que ordena el ESP32. Con el mando, la caja mueve el escritorio y el firmware no
    tenía estado que cambiar, aunque veía la altura cambiar en el bus.
    Ahora se deduce: altura que cambia con el ESP32 en reposo = alguien con el dedo
    en el botón. El sensor publica "subiendo (mando)" / "bajando (mando)", así que
    en HA se ve quién movió el escritorio. Vuelve a quieto a los 4 s.
    Beneficio de seguridad: la automatización que para el escritorio si desaparece
    la presencia ahora cubre un movimiento continuo arrancado a mano y dejado
    corriendo, que antes le era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
2026-08-28 La postura solo cuenta en las alturas de trabajo
    "si pauso una actividad de subir o bajar, igual cuenta como si hubiera subido"
    — cierto. La postura salía de un umbral único en 95 cm, con dos efectos que
    llegaban hasta las estadísticas del día: cambiaba a mitad de viaje al cruzar
    los 95, y un viaje interrumpido a 96 contaba como "de pie" indefinidamente.
    La solución es del propietario y es mejor que la que propuse: solo cuenta estar
    en 80 (sentado) o 117 (de pie), ±3 cm. Todo lo demás es "intermedia" y no
    arranca ningún contador. Si no estás en una postura de trabajo, no hay nada que
    cronometrar.
    La auditoría documentó además eslabones que no estaban recogidos: presencia
    sost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
2026-08-31 El sensor de presencia perdía a una persona quieta: retardo a 120 s
    "se supone que el escritorio debió bajar" ... "pero si estaba, no me he movido
    de aquí". El recordatorio disparó y avisó correctamente, pero al re-verificar
    presencia dos minutos después el sensor dijo que no había nadie.
    Causa: el 23 de agosto bajé el retardo del SNZB-06P de 90 a 30 s para detectar
    antes las ausencias, y solo pesé esa cara. Un mmWave sigue a la persona por la
    respiración; con 30 s, alguien trabajando muy quieto desaparece. El fallo era
    silencioso: la automatización se cancelaba "correctamente".
    Arreglado: retardo a 120 s, y el disparo pasa a usar la presencia sostenida
    (delay_off 15 min) en vez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
2026-08-31 uso_manual se publica siempre: la regla de cortesía no protegía nada
    El sensor solo aparecía tras la primera pulsación del mando desde el arranque,
    así que tras cada reinicio la entidad no existía y la condición "no muevas el
    escritorio si se ajustó a mano hace menos de 5 min" no protegía nada.
    Ahora se publica siempre; sin pulsaciones vale 99999, que no es un dato ausente
    sino "hace muchísimo".
    Mismo patrón que ya mordió antes: una condición de seguridad que al no poder
    evaluarse deja de proteger en silencio.
2026-09-02 Tres horas avisando sin mover: la comprobación preguntaba al sensor equivocado
    El recordatorio de postura avisaba y no movía el escritorio. Los registros del
    recorder muestran nueve disparos el 2026-09-02 y solo dos movimientos: los demás
    completaban los 110 s de espera y se cancelaban en silencio.
    Dos causas, las dos medidas:
    - La re-verificación previa al movimiento preguntaba al sensor de presencia
    crudo, que parpadea cada 1-2 minutos con una persona sentada delante. Decenas
    de transiciones en seis horas frente a 4 del sensor sostenido. Cualquier
    comprobación instantánea contra el crudo es una moneda al aire.
    - Cada reinicio de Home Assistant borraba las horas acumuladas: la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
2026-09-02 README y SEGURIDAD en inglés; la bitácora se parte en dos
    El repositorio es público y la documentación de cara al exterior pasa a inglés.
    La bitácora y los ADR se quedan en español a propósito: son un diario escrito
    mientras ocurría el proyecto, y traducirlo a posteriori arriesga convertir un
    supuesto registrado en un hecho afirmado, que es justo contra lo que este
    repositorio documenta. La tabla del README dice el idioma de cada documento.
    BITACORA.md pasa de 3531 a 1105 líneas. Las 11 entradas de las fases 1 a 3
    (2026-08-02 a 2026-08-22) se mueven íntegras a
    docs/historia/BITACORA-fases-1-3.md. No se ha borrado ni editado una palabra, y
    BITACORA.md deja constancia de dónde est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
2026-09-02 README pequeños en inglés y la regla de idioma, escrita
    Se traducen tools/, firmware/backups/, datasheets/, fotografias/ y capturas/.
    Y se deja escrito por qué la bitácora y los ADR NO se traducen: son un diario
    escrito mientras pasaban las cosas, con la distinción medido/supuesto/descartado
    incrustada en el modo de decirlo, y la forma más fácil de estropear un supuesto
    es traducirlo con prisa hasta que suene a hecho. Los ADR además son inmutables:
    traducir es editar.
    Los nombres de archivo se quedan como están aunque el contenido pase a inglés.
    Renombrarlos rompería enlaces desde documentos que no se tocan.
2026-09-02 PCB_ESPECIFICACION en inglés
2026-09-02 firmware/README en inglés, y una sección que llevaba semanas mintiendo
    Decía "qué está sin verificar: todo, nunca se ha ejecutado con hardware
    conectado" cuando el firmware llevaba semanas gobernando el escritorio. Sobrevivió
    porque nada obliga a releer un documento cuando cambia lo que describe. Se corrige
    y se deja el texto viejo citado, que es lo que pide la política.
2026-09-02 INTEGRACION_HA en inglés, y el umbral de 95 cm que sobrevivió a su propia corrección
    El documento describía la postura con un umbral único en 95 cm dos secciones más
    abajo de la sección que explica por qué ese umbral se eliminó el 2026-08-28. El
    texto viejo aguantó cuatro días debajo de su propia corrección: es lo que pasa
    cuando se arregla en un sitio y no se relee el documento entero.
2026-09-02 HARDWARE en inglés, y una línea que decía conectar el cable equivocado
    La última línea del documento decía "el hilo rojo del escritorio no se conecta".
    El rojo es CLK y sí se conecta; el que no se conecta nunca es el amarillo, que
    son los 5 V. El resto del documento lo dice bien en cuatro sitios y esa línea
    sola los contradecía a todos. Quien la leyera y actuara al revés conectaría 5 V
    a un GPIO de 3.6 V.
    Se reconstruye además una tabla huérfana, partida de su cabecera y varada a
    mitad de sección, que se renderizaba como texto suelto. Ninguna cifra cambia.
2026-09-02 PLAN en inglés, y 158 enlaces que rompí al archivar la bitácora
    Mover las entradas a docs/historia/ cambió el nivel de las rutas relativas y dejó
    158 enlaces apuntando a ninguna parte. Detectado por una comprobación mecánica de
    todos los enlaces del repositorio, no a ojo. Arreglados, y de paso los que ya
    estaban rotos en README-2026-07-27.md desde antes.
    PLAN.md era el documento peor envejecido: casillas sin marcar de trabajo
    terminado un mes antes ("soldar las derivaciones <- aquí estamos", con las
    derivaciones puestas desde el 2026-08-06), una tabla que daba el ancho de pulso
    en 300 ms cuando ADR-027 lo subió a 800 hacía doce días, y una frase cortada a
    mitad que no decía nada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
2026-09-03 El enlace Zigbee no es el problema: LQI 199 contra el coordinador
    El propietario movió el sensor a un USB de la Pi y pregunté por interferencias.
    Respondí que sí las había, y una de mis tres razones era que el coordinador está
    dentro del mismo rack metálico. Nunca se estableció dónde está el coordinador:
    lo supuse y lo escribí como hecho. Él lo señaló.
    Medido en zigbee.db en vez de discutido: el sensor lo ven cuatro routers con LQI
    200, 199, 121 y 112 sobre 255, y el 199 es directo al coordinador. Mejor que la
    mayoría de dispositivos de la red, que están entre 110 y 170.
    Hipótesis descartada. No hay que recolocar nada. El parpadeo queda acotado a la
    detección mmWave, no a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
2026-09-03 El escritorio subió sin nadie delante, por mi arreglo del día anterior
    El 2026-09-03 a las 13:16:56 el escritorio subió solo. Los registros: el sensor
    en off desde las 13:13:58 y unavailable desde las 13:16:00, y la presencia
    sostenida no admitió la ausencia hasta las 13:28:58, doce minutos tarde.
    Causa: el 2026-09-02 moví la re-verificación previa al movimiento del sensor
    crudo a presencia_sostenida, que tiene delay_off de 15 minutos. Arreglé las
    cancelaciones falsas y abrí esto, que es peor: SEGURIDAD.md exige confirmación
    de que hay alguien delante y esto aceptaba una de hacía un cuarto de hora.
    El error de fondo fue usar un sensor para dos preguntas con tolerancias
    distintas.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
2026-09-03 Y el mismo día el fallo contrario: un parpadeo de 2 s frenó un viaje legítimo
    Pulsó memoria 1 y el escritorio paró en 111 en vez de llegar a 80. Causa medida:
    a las 14:18:38 el sensor de presencia parpadeó a off durante dos segundos, la
    automatización que frena si desapareces disparó y publicó parar. Estaba sentado
    delante. Pulsó otra vez 45 s después y bajó los 29 cm sin problema.
    Y lo agravó mi arreglo de esa misma mañana: añadir unavailable y unknown al
    vigilante lo hizo más sensible, así que la capa que frena cuando te vas empezó a
    frenar estando tú.
    Arreglado con confirmación de 10 s en el disparador. Coste declarado: si la
    ausencia es real, frena 10 s más tarde,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
2026-09-03 La confirmación baja de 10 a 5 s, y el número sale de medir
    El propietario pidió acortarla. En vez de elegir a ojo se midieron 484 ausencias
    del sensor crudo en 7 días: 9 por debajo de 2 s, 6 entre 2 y 3, 11 entre 3 y 5,
    37 entre 5 y 10, y 421 por encima de 10.
    Tenía razón. El parpadeo que abortó el viaje duró 2 s, así que 5 s da dos veces
    y media de margen, mientras que 10 s se tragaba además parpadeos de hasta diez
    segundos, que ya parecen una ausencia real.
    Coste: frena 5 s más tarde, unos 3.4 cm de recorrido extra sobre un viaje de
    ~65 s.
2026-09-04 Capa 0: los recordatorios solo actúan con el GPS en casa
    Petición del propietario. Se usa person.cesar_augusto, que es el criterio que ya
    usan las demás automatizaciones de la casa, y va como primera condición: al
    mmWave se le puede discutir, al GPS del móvil no.
    NO se añade a la automatización que frena el escritorio en marcha. Esa es de
    seguridad: si el escritorio se mueve con la casa vacía eso es más motivo para
    frenar, no menos, y condicionarla apagaría la protección justo cuando más hace
    falta.
2026-09-04 Quinto ajuste del mismo umbral: el problema no es el número
    A las 17:31:54 el escritorio subió con el propietario fuera del estudio, 118 s
    después de la última detección real. La tolerancia de 3 minutos lo permitió, y el
    GPS no ayudó: estaba en casa, pero casa no es habitación.
    Bajado a 60 s, que habría bloqueado este caso. Pero queda escrito que el umbral
    lleva cinco ajustes y que cada uno mueve el fallo de un lado al otro: subirlo
    mueve el escritorio sin nadie, bajarlo frena con alguien sentado. El mmWave no
    distingue "sentado quieto" de "se fue", y toda la cadena cuelga de esa señal.
    Lo que lo arregla es una segunda señal independiente que afirme en positivo que
    está ahí. b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
2026-09-05 Revertido a como funcionaba, más un interruptor maestro
    El propietario: "como lo temíamos hace una semana, justo antes de hacer todos
    estos ajustes funcionaba perfecto". Tiene razón en el dato: cinco ajustes en dos
    días, cada uno moviendo el fallo al otro lado, y la semana anterior el sistema
    hacía su trabajo.
    La re-verificación previa a mover vuelve al sensor crudo y la vigilancia durante
    el viaje a solo off sin ventana de confirmación. Se conserva lo que no toca la
    cuestión de la presencia: el contador sobreviviendo a reinicios, la postura solo
    en las alturas de trabajo, y la condición de GPS.
    Y se implementa input_boolean.escritorio_automatico, que llevaba en el catálogo
    como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
2026-09-07 El interruptor maestro no mandaba: tres días encendiendo nada
    "No está funcionando". Las dos automatizaciones de recordatorio llevaban
    deshabilitadas desde el 2026-09-04 a las 21:05, mientras el propietario
    encendía y apagaba el interruptor Automatico sin efecto.
    Fallo de diseño mío: implementé el interruptor solo como condición dentro de las
    automatizaciones, así que podía estar en on con la automatización apagada por
    debajo. Dos formas de apagar lo mismo, ciegas entre sí, y la visible no era la
    que mandaba.
    Se añade escritorio_maestro_sincroniza: encender el interruptor rehabilita las
    dos automatizaciones, apagarlo las deshabilita, y se ejecuta también al arrancar
    HA para qu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
2026-09-07 Los 35 minutos de pie los imponía el umbral, no el propietario
    "Se me están haciendo cortas las iteraciones." Medidos 7 días de periodos de
    pie: mediana 35 min, repetida una y otra vez. No es una costumbre, es
    aritmética: 30 min de umbral más los 110 s de cortesía. Los periodos sentado
    daban 50 min por lo mismo, con su umbral de 45.
    El escritorio imponía 35 de pie por cada 50 sentado, proporción que no eligió
    nadie: salió de poner dos umbrales por separado. Igualados a 45 y 45.
    Y queda anotado un descuido: el script que subió el umbral reemplazó 1800 en
    toda la automatización, y la condición de no repetir el aviso usaba ese mismo
    número. Se cambió sin querer y se devolvió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
2026-09-08 Los umbrales pasan a basarse en recomendaciones publicadas
    Sentado baja de 45 a 30 min; de pie se queda en 45.
    Lo consistente en la literatura es que romper el tiempo sentado importa más que
    acumular horas de pie, así que el umbral que debe apretar es el de sentado.
    Cornell sitúa la ruptura del sedentarismo cada ~30 min; el consenso de Buckley
    et al. (BJSM 2015) fija 2-4 h de pie por jornada; y la bipedestación estática
    continua por encima de una hora se asocia a molestias lumbares y de piernas.
    En jornada de 8 h esto queda cerca de 4 h de pie, el extremo superior del
    consenso. Queda anotado que es orientación general y no consejo médico, y que lo
    que más subrayan las fuentes es ju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
2026-09-10 Un default de más apagó los recordatorios nueve horas y media
    El sincronizador del 2026-09-07 tenía un "default: turn_off" en su choose, que
    se ejecuta ante cualquier estado que no sea on, incluido el unknown que muestra
    un input_boolean mientras HA arranca. Con el corte de luz del 09-09 a las 22:28
    dejó los recordatorios apagados hasta las 07:50 del día siguiente, con el
    interruptor del panel diciendo on todo el rato.
    Arreglado con dos ramas explícitas y sin default: si el interruptor no se puede
    leer, no se toca nada. Un estado ilegible no es una orden de apagar.
    El ESP32 se reconectó 12 veces entre las 22:28 y la 01:36 tras el corte,
    disparando un aviso en cada una mientras el pr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
2026-09-11 La tarjeta Postura dice a qué hora se moverá el escritorio
    Sensor nuevo en HA, escritorio_proximo_cambio, que replica las condiciones de
    los recordatorios (umbral, no repetir en 30 min, disparo cada 5 min y 110 s de
    espera) y da la hora del movimiento, o "en movimiento", o por qué no habrá
    cambio. Verificado en vivo: predijo 12:07 y el escritorio arrancó a las 12:06:54.
    El "por X min" de la tarjeta cuenta ahora desde inicio_postura y no desde el
    último reinicio de HA, que era lo que la desincronizaba. Los umbrales quedan
    duplicados entre automations.yaml y el sensor.
    Un reinicio con docker restart (10 s) no dejó a HA guardar su estado: devolvió
    inicio_postura a un valor de 31 min a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
2026-09-29 El escritorio bajó dos veces hasta el tope: la cesión de paso no frena
    Medido en el recorder: 2026-09-25 11:41 y 2026-09-29 15:41, las dos veces
    bajando desde 115 hasta 73 cm, el tope físico, sin que nadie frenara.
    La causa está en el firmware. pulseChannelFor descodifica solo la última ráfaga
    del pulso (2-3 ms contra un barrido de teclado de ~40 ms), así que a menudo no ve
    su propia tecla, y la atribución se cierra con la primera lectura. Una lectura
    posterior de la misma pulsación pasa por humana, y entonces la cesión de paso no
    frena porque supone que la persona ya frenó. Cuando eso cae al arrancar el pulso
    largo, la marcha continua se queda sin nadie que la pare.
    De 33 cesio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
2026-09-29 Ceder el paso al mando ahora frena si hay un viaje en curso (ADR-035)
    Arreglo del fallo que bajó el escritorio hasta su tope dos veces (2026-09-25 y
    2026-09-29, de 115 a 73 cm).
    Dos cambios en desk_sniffer.ino. La atribución compara el código de tecla
    (CH_KEY[], verificados en el bus el 2026-08-22) y dura toda la ventana, en vez de
    cerrarse con la primera lectura: así una segunda lectura de nuestra propia
    pulsación ya no pasa por humana. Y ceder el paso con un viaje en curso llama a
    stopTravel, que verifica el freno y lo reintenta, en vez de soltar la intención
    sin frenar.
    La revisión adversarial encontró que la primera versión dejaba el mismo agujero un
    estado más allá: forzaba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
2026-10-14 El arreglo del firmware, verificado en campo
    Un viaje real con el firmware nuevo: el recordatorio disparó a las 18:25, publicó
    el objetivo a las 18:26:50, el escritorio bajó y FRENÓ solo en el objetivo a las
    18:27:34, quedando en 81 y ajustando a 80. Sin cesión de paso indebida y sin
    pasarse. Step 0 cerrado.
    Quedan sin commit, a petición del propietario, los cambios que son solo de Home
    Assistant.
